Hardware7253/OperationBaldr/README.md

# Operation Baldr

A VFD clock
