Hardware7253/OperationBaldr/cad/case/Baldr.step

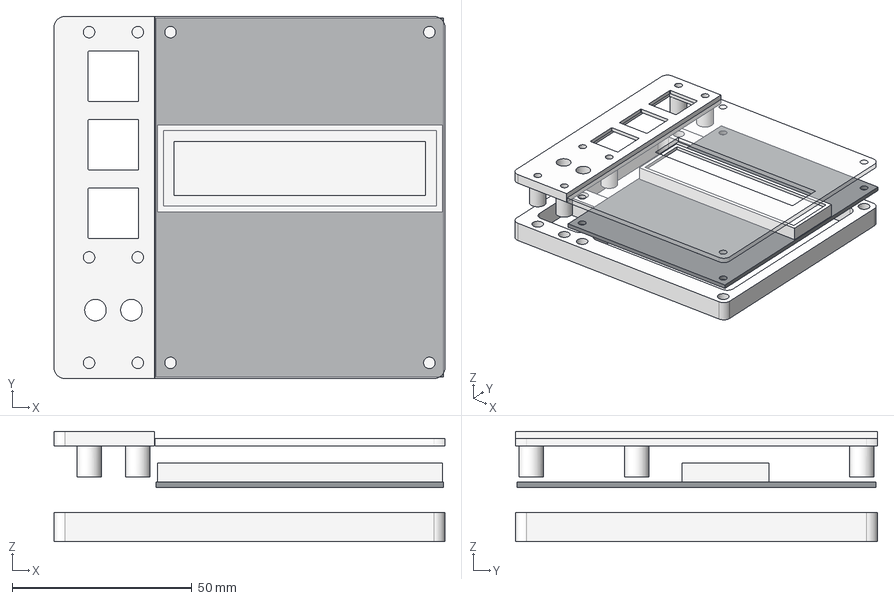
[picture p1: CAD file, 2024-08-28]
cad/case/Baldr.step
108.8 x 100.7 x 30.6 mm
