Hardware7253/OperationBaldr/cad/pcb/OperationBaldr.kicad_pcb

## KiCad design cad/pcb/OperationBaldr.kicad_pcb (2024-08-28)

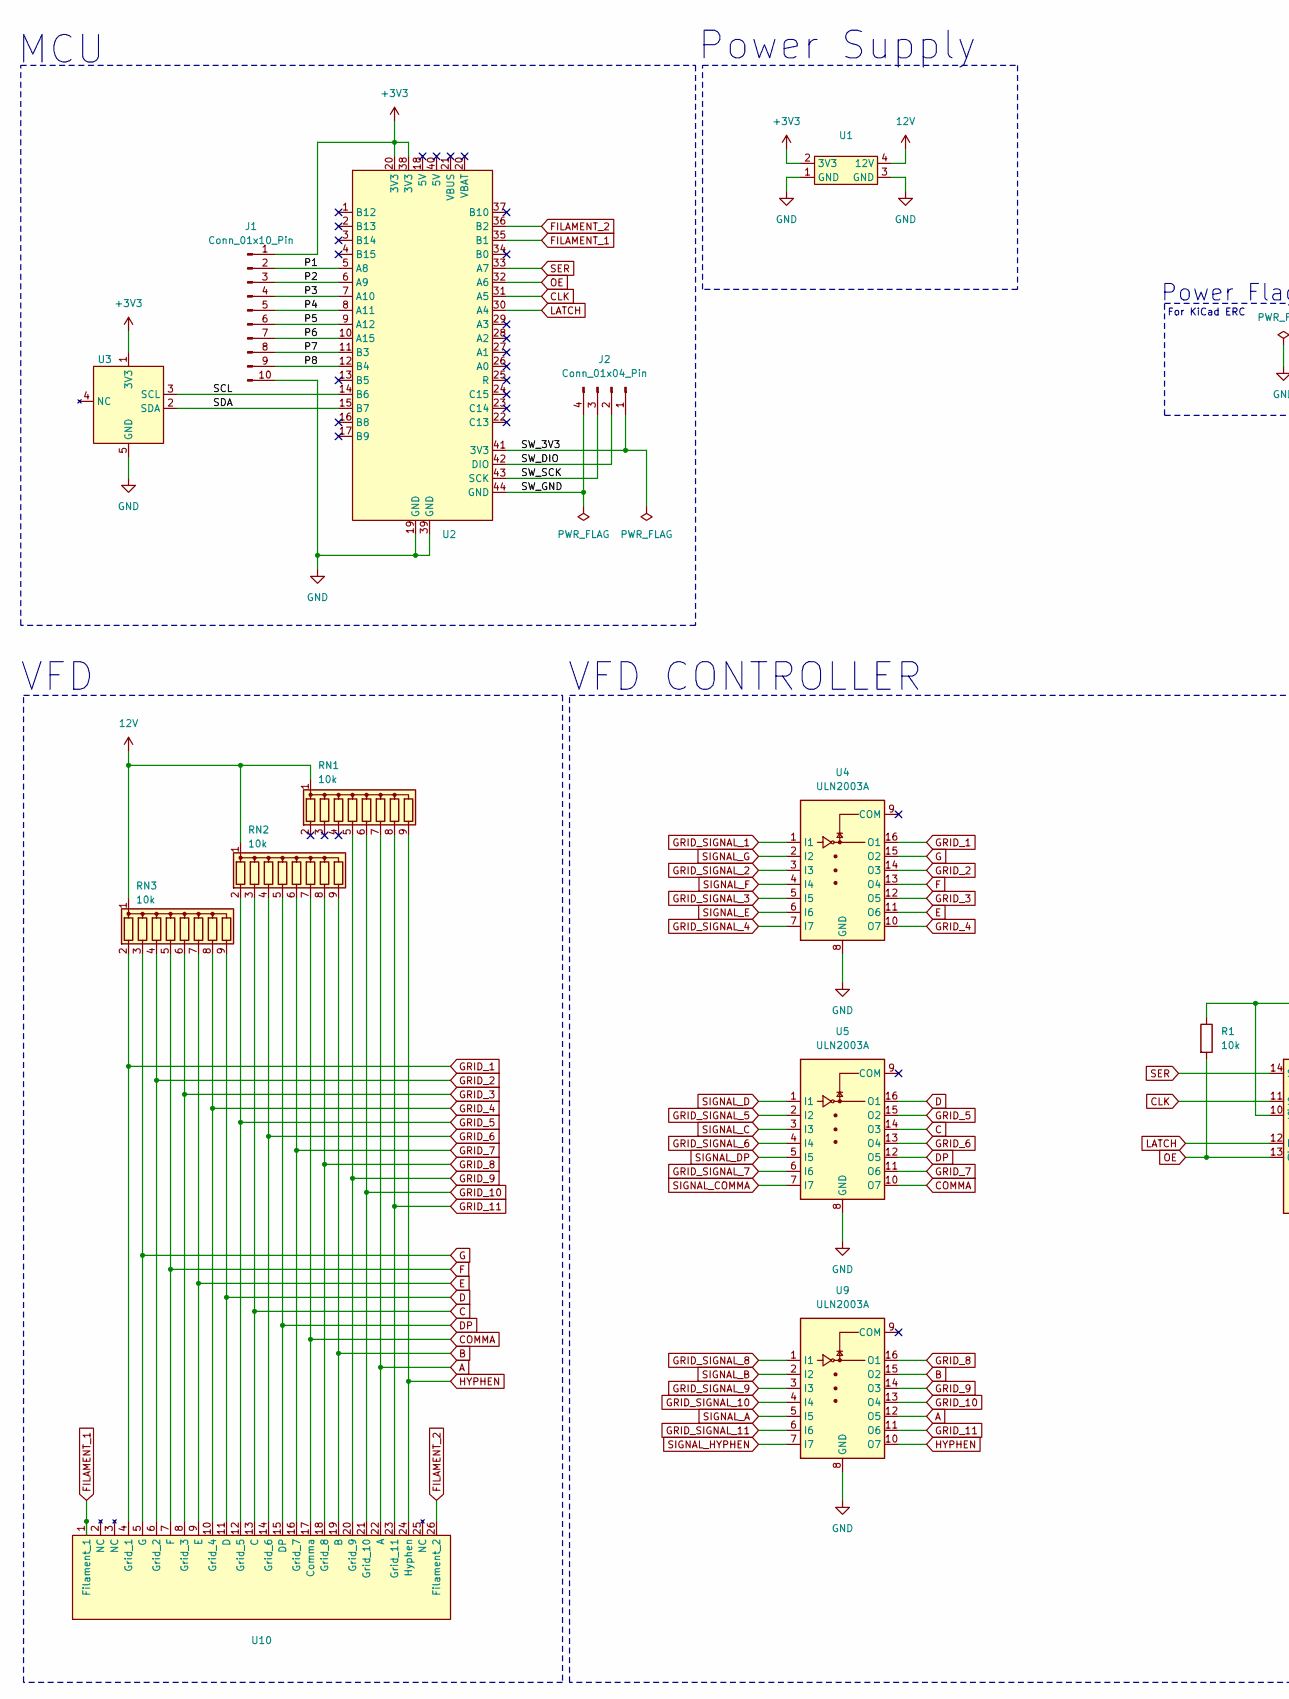
[picture p2: schematic OperationBaldr.kicad_sch, Baldr Schematic, part in row 1, column 1]

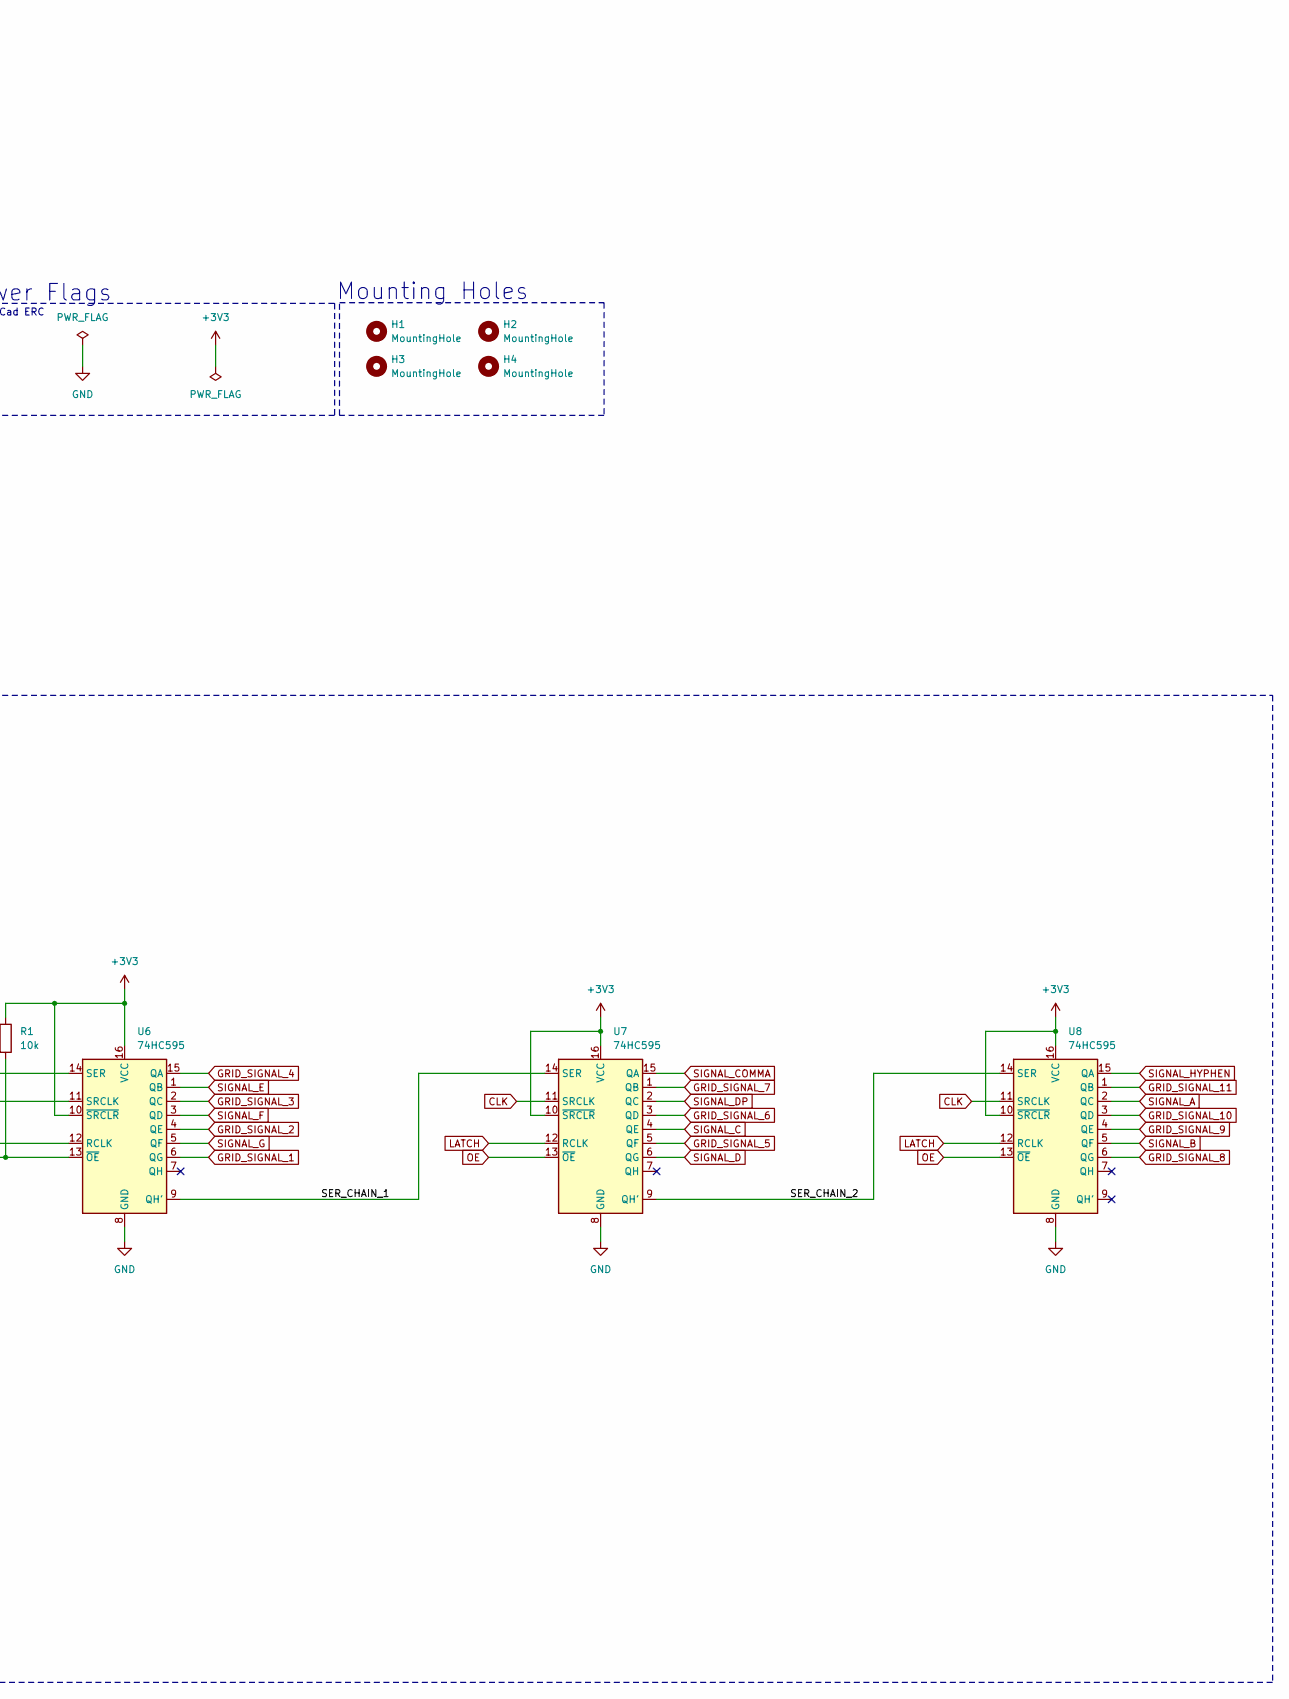
[picture p3: schematic OperationBaldr.kicad_sch, Baldr Schematic, part in row 1, column 2]

Parts:
H1, H2, H3, H4: MountingHole; MountingHole_3.2mm_M3
J1: Conn_01x10_Pin; PinHeader_1x10_P2.54mm_Vertical
J2: Conn_01x04_Pin; PinHeader_1x04_P2.54mm_Horizontal
R1: 10k; R_Axial_DIN0207_L6.3mm_D2.5mm_P10.16mm_Horizontal
RN1, RN2, RN3: 10k; R_Array_SIP9
U1: DC_step_up
U2: STM32_blackpill
U3: RTC
U4, U5, U9: ULN2003A; DIP-16_W7.62mm_Socket
U6, U7, U8: 74HC595; DIP-16_W7.62mm_Socket
U10: ZD1880

Connections:
12V: RN1.1 (common), RN2.1 (common), RN3.1 (common), U1.4 (12V)
+3V3: J1.1, R1.1, U1.2 (3V3), U2.20 (3V3), U2.38 (3V3), U3.1 (3V3), U6.10 (~SRCLR), U6.16 (VCC), U7.10 (~SRCLR), U7.16 (VCC), U8.10 (~SRCLR), U8.16 (VCC)
/P1: J1.2, U2.5 (A8)
/P2: J1.3, U2.6 (A9)
/P3: J1.4, U2.7 (A10)
/P4: J1.5, U2.8 (A11)
/P5: J1.6, U2.9 (A12)
/P6: J1.7, U2.10 (A15)
/P7: J1.8, U2.11 (B3)
/P8: J1.9, U2.12 (B4)
/SCL: U2.14 (B6), U3.3 (SCL)
/SDA: U2.15 (B7), U3.2 (SDA)
/SER_CHAIN_1: U6.9 (QH'), U7.14 (SER)
/SER_CHAIN_2: U7.9 (QH'), U8.14 (SER)
/SW_3V3: J2.1, U2.41 (3V3)
/SW_DIO: J2.2, U2.42 (DIO)
/SW_GND: J2.4, U2.44 (GND)
/SW_SCK: J2.3, U2.43 (SCK)
A: RN1.7 (R6), U9.12 (O5), U10.22 (A)
B: RN2.9 (R8), U9.15 (O2), U10.19 (B)
C: RN2.3 (R2), U5.14 (O3), U10.13 (C)
CLK: U2.31 (A5), U6.11 (SRCLK), U7.11 (SRCLK), U8.11 (SRCLK)
COMMA: RN2.7 (R6), U5.10 (O7), U10.17 (Comma)
D: RN3.9 (R8), U5.16 (O1), U10.11 (D)
DP: RN2.5 (R4), U5.12 (O5), U10.15 (DP)
E: RN3.7 (R6), U4.11 (O6), U10.9 (E)
F: RN3.5 (R4), U4.13 (O4), U10.7 (F)
FILAMENT_1: U2.35 (B1), U10.1 (Filament_1)
FILAMENT_2: U2.36 (B2), U10.26 (Filament_2)
G: RN3.3 (R2), U4.15 (O2), U10.5 (G)
GND: J1.10, U1.1 (GND), U1.3 (GND), U2.19 (GND), U2.39 (GND), U3.5 (GND), U4.8 (GND), U5.8 (GND), U6.8 (GND), U7.8 (GND), U8.8 (GND), U9.8 (GND)
GRID_1: RN3.2 (R1), U4.16 (O1), U10.4 (Grid_1)
GRID_2: RN3.4 (R3), U4.14 (O3), U10.6 (Grid_2)
GRID_3: RN3.6 (R5), U4.12 (O5), U10.8 (Grid_3)
GRID_4: RN3.8 (R7), U4.10 (O7), U10.10 (Grid_4)
GRID_5: RN2.2 (R1), U5.15 (O2), U10.12 (Grid_5)
GRID_6: RN2.4 (R3), U5.13 (O4), U10.14 (Grid_6)
GRID_7: RN2.6 (R5), U5.11 (O6), U10.16 (Grid_7)
GRID_8: RN2.8 (R7), U9.16 (O1), U10.18 (Grid_8)
GRID_9: RN1.5 (R4), U9.14 (O3), U10.20 (Grid_9)
GRID_10: RN1.6 (R5), U9.13 (O4), U10.21 (Grid_10)
GRID_11: RN1.8 (R7), U9.11 (O6), U10.23 (Grid_11)
GRID_SIGNAL_1: U4.1 (I1), U6.6 (QG)
GRID_SIGNAL_2: U4.3 (I3), U6.4 (QE)
GRID_SIGNAL_3: U4.5 (I5), U6.2 (QC)
GRID_SIGNAL_4: U4.7 (I7), U6.15 (QA)
GRID_SIGNAL_5: U5.2 (I2), U7.5 (QF)
GRID_SIGNAL_6: U5.4 (I4), U7.3 (QD)
GRID_SIGNAL_7: U5.6 (I6), U7.1 (QB)
GRID_SIGNAL_8: U8.6 (QG), U9.1 (I1)
GRID_SIGNAL_9: U8.4 (QE), U9.3 (I3)
GRID_SIGNAL_10: U8.3 (QD), U9.4 (I4)
GRID_SIGNAL_11: U8.1 (QB), U9.6 (I6)
HYPHEN: RN1.9 (R8), U9.10 (O7), U10.24 (Hyphen)
LATCH: U2.30 (A4), U6.12 (RCLK), U7.12 (RCLK), U8.12 (RCLK)
OE: R1.2, U2.32 (A6), U6.13 (~OE), U7.13 (~OE), U8.13 (~OE)
SER: U2.33 (A7), U6.14 (SER)
SIGNAL_A: U8.2 (QC), U9.5 (I5)
SIGNAL_B: U8.5 (QF), U9.2 (I2)
SIGNAL_C: U5.3 (I3), U7.4 (QE)
SIGNAL_COMMA: U5.7 (I7), U7.15 (QA)
SIGNAL_D: U5.1 (I1), U7.6 (QG)
SIGNAL_DP: U5.5 (I5), U7.2 (QC)
SIGNAL_E: U4.6 (I6), U6.1 (QB)
SIGNAL_F: U4.4 (I4), U6.3 (QD)
SIGNAL_G: U4.2 (I2), U6.5 (QF)
SIGNAL_HYPHEN: U8.15 (QA), U9.7 (I7)

Notes on the sheet:
For KiCad ERC
VFD CONTROLLER
Mounting Holes
Power Flags
VFD
MCU
Power Supply

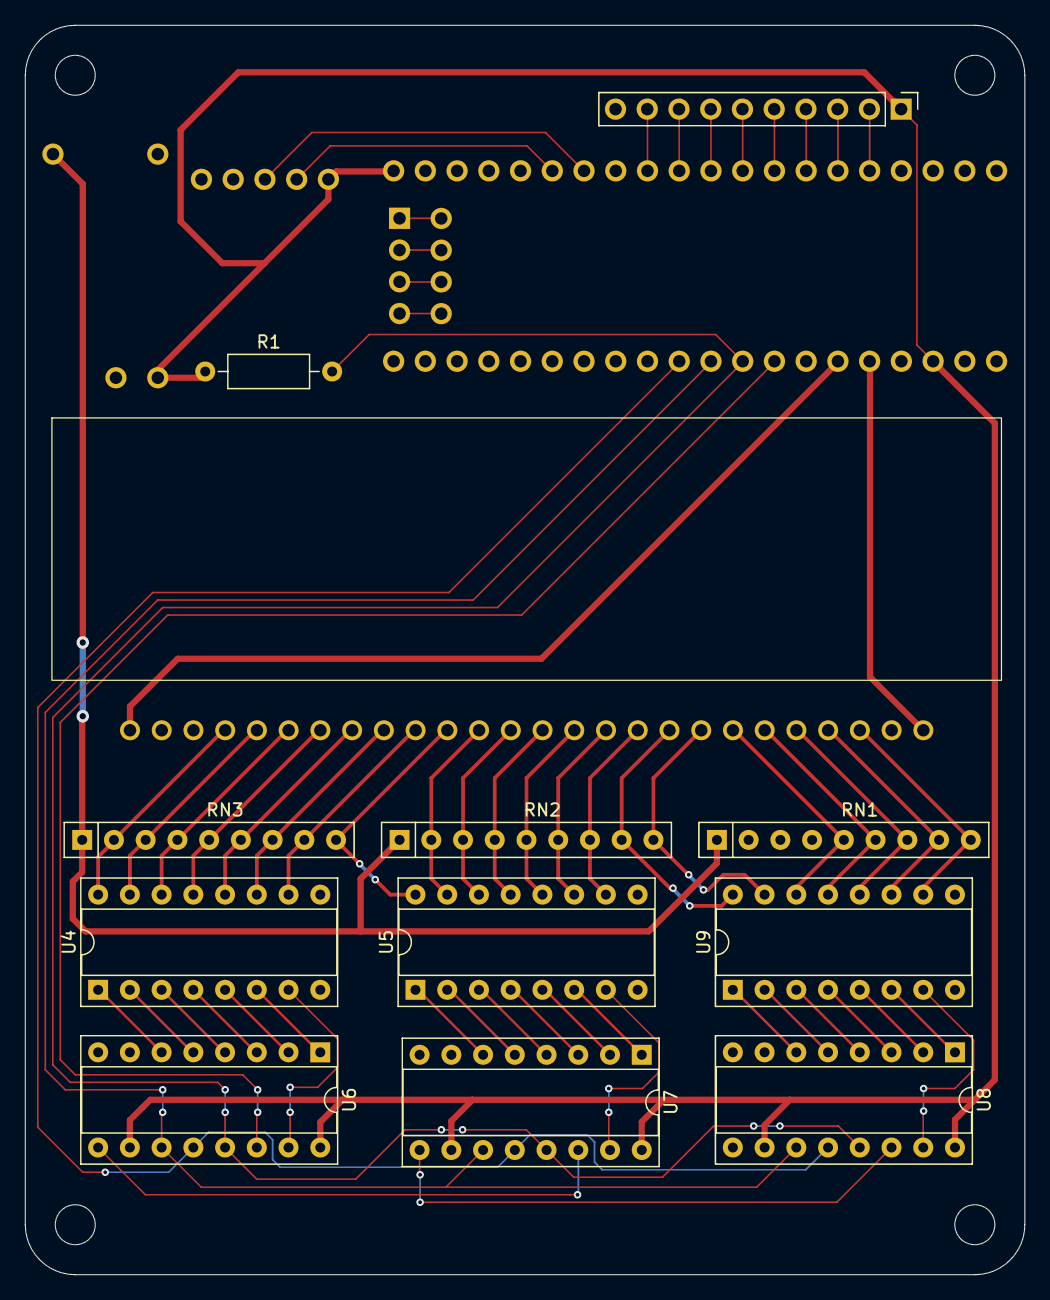
[picture p4: board OperationBaldr.kicad_pcb from above]

Board: 2 copper layers, 80.0 x 100.0 mm, 20 parts (1 on the bottom side), 67 nets.
