Hardware7253/OperationBaldr/(commit log)

2024-06-19 updated gerbers
    [OperationBaldr-B_Cu.gbr, OperationBaldr-B_Mask.gbr, OperationBaldr-B_Paste.gbr, OperationBaldr-B_Silkscreen.gbr, OperationBaldr-Edge_Cuts.gbr, OperationBaldr-F_Cu.gbr, OperationBaldr-F_Mask.gbr, OperationBaldr-F_Paste.gbr]
2024-07-05 Added cad directory
    Added cad directory with casing step file. Also made a minor
    schematic revision (adding values to the resistor networks).
    [Baldr.step, OperationBaldr.kicad_pcb, OperationBaldr.kicad_sch]
2024-08-28 Added embedded rust code
    Added an embedded rust program to control the device.
    Also restructered file hierarchy, and made revisions to schematic/pcb.
    [Baldr.step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]
2024-10-01 Changed button pins
    Changed button pins to avoid using the USB and SWD pins
    [button.rs, main.rs, vfd.rs]
